UQ-SCUBA/Solid-Cell-Reader-/solid cells/BOM_Board1_PCB1_2026-08-20.csv

No. | Quantity | Comment | Designator | Footprint | Value | Manufacturer Part | Manufacturer | Supplier Part | Supplier
1 | 2 | 10uF | C3,C5 | C0603 | 10uF | CL10A106KP8NNNC | SAMSUNG(三星) | C19702 | LCSC
2 | 4 | 100nF | C4,C6,C7,C8 | C0603 | 100nF | CT41G-0603-2X1-50V-0.1uF-K(N) | TORCH(火炬) | C125205 | LCSC
3 | 2 | B3B-PH-K-S(LF)(SN) | CellOut,Head | CONN-TH_B3B-PH-K-S |  | B3B-PH-K-S(LF)(SN) | JST | C131339 | LCSC
4 | 2 | AO3401A | Cell_pwr_Q2,Wake_Q1 | SOT-23-3_L2.9-W1.3-P1.90-LS2.4-BR |  | AO3401A | YONGYUTAI(永裕泰) | C49396278 | LCSC
5 | 1 | BAV99 | D1 | SOT-23-3_L2.9-W1.4-P1.90-LS2.6-BR |  | BAV99 | IDCHIP(英锐芯) | C2848190 | LCSC
6 | 1 | B5B-PH-K-S(LF)(SN) | Program | CONN-TH_B5B-PH-K-S-LF-SN |  | B5B-PH-K-S(LF)(SN) | JST | C157993 | LCSC
7 | 1 | 20kΩ | R1 | R0603 | 20kΩ | RT0603BRD0720KL | YAGEO(国巨) | C723637 | LCSC
8 | 1 | 1kΩ | R2 | R0603 | 1kΩ | RT0603BRE071KL | YAGEO(国巨) | C513397 | LCSC
9 | 1 | 15Ω | R3 | R0603 | 15Ω | RC0603FR-0715RL | YAGEO(国巨) | C128059 | LCSC
10 | 3 | 10kΩ | R4,R5,R8 | R0603 | 10kΩ | RC0603FR-0710KL | YAGEO(国巨) | C98220 | LCSC
11 | 2 | 100kΩ | R6,R7 | R0603 | 100kΩ | RC0603FR-07100KL | YAGEO(国巨) | C14675 | LCSC
12 | 1 | B4B-PH-K-S(LF)(SN) | SolidCell | CONN-TH_B4B-PH-K-S |  | B4B-PH-K-S(LF)(SN) | JST | C131334 | LCSC
13 | 1 | STM32G051F8P6 | U1 | TSSOP-20_L6.5-W4.4-P0.65-LS6.4-BL |  | STM32G051F8P6 | ST(意法半导体) | C5270207 | LCSC
14 | 1 | MCP1703AT-3302E/CB | U2 | SOT-23-3_L2.9-W1.3-P1.90-LS2.4-BR |  | MCP1703AT-3302E/CB | MICROCHIP(美国微芯) | C144183 | LCSC
