UQ-SCUBA/Solid-Cell-Reader-/solid cells/SCH_Schematic1_2026-08-20.pdf

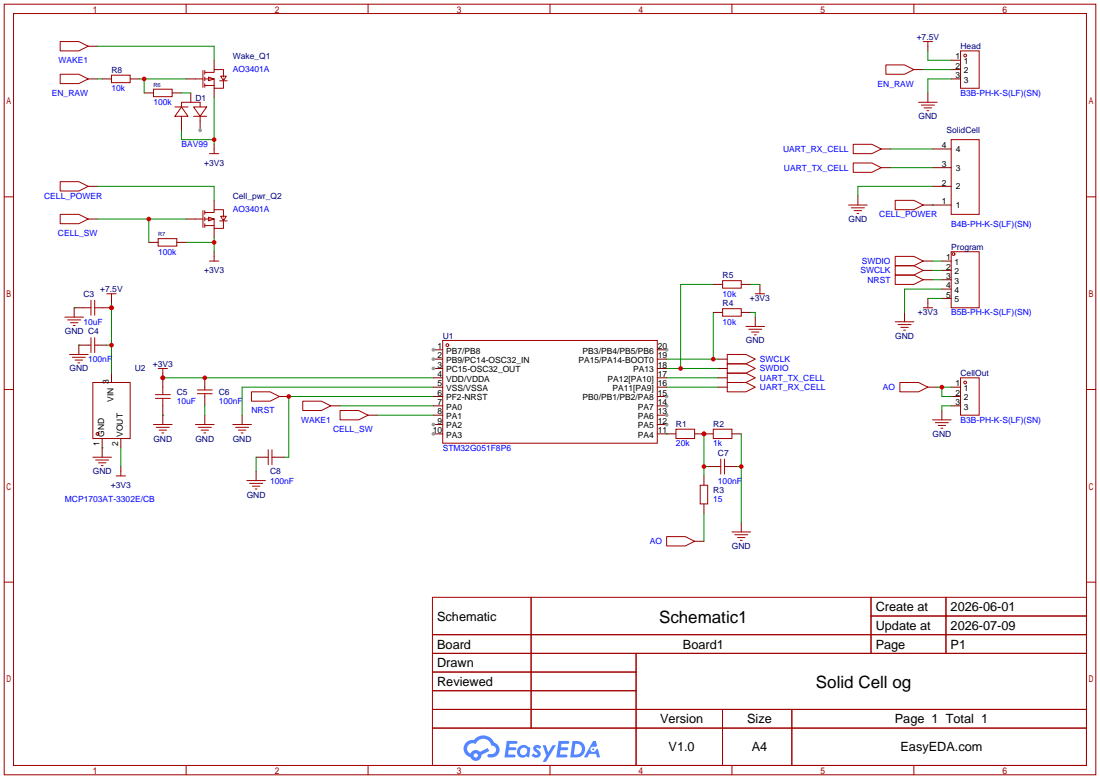
[picture p1: page 1]

Schematic | Schematic1 | Create at | 2026-06-01

Update at | 2026-07-09

Board | Board1 | Page | P1
Drawn | | Solid Cell og
Reviewed

Version | Size | Page 1 Total 1
V1.0 | A4 | EasyEDA.com
