UQ-SCUBA/Solid-Cell-Reader-/BabysFirstCell.kicad_pcb

## KiCad design BabysFirstCell.kicad_pcb (2026-03-29, last stored version)

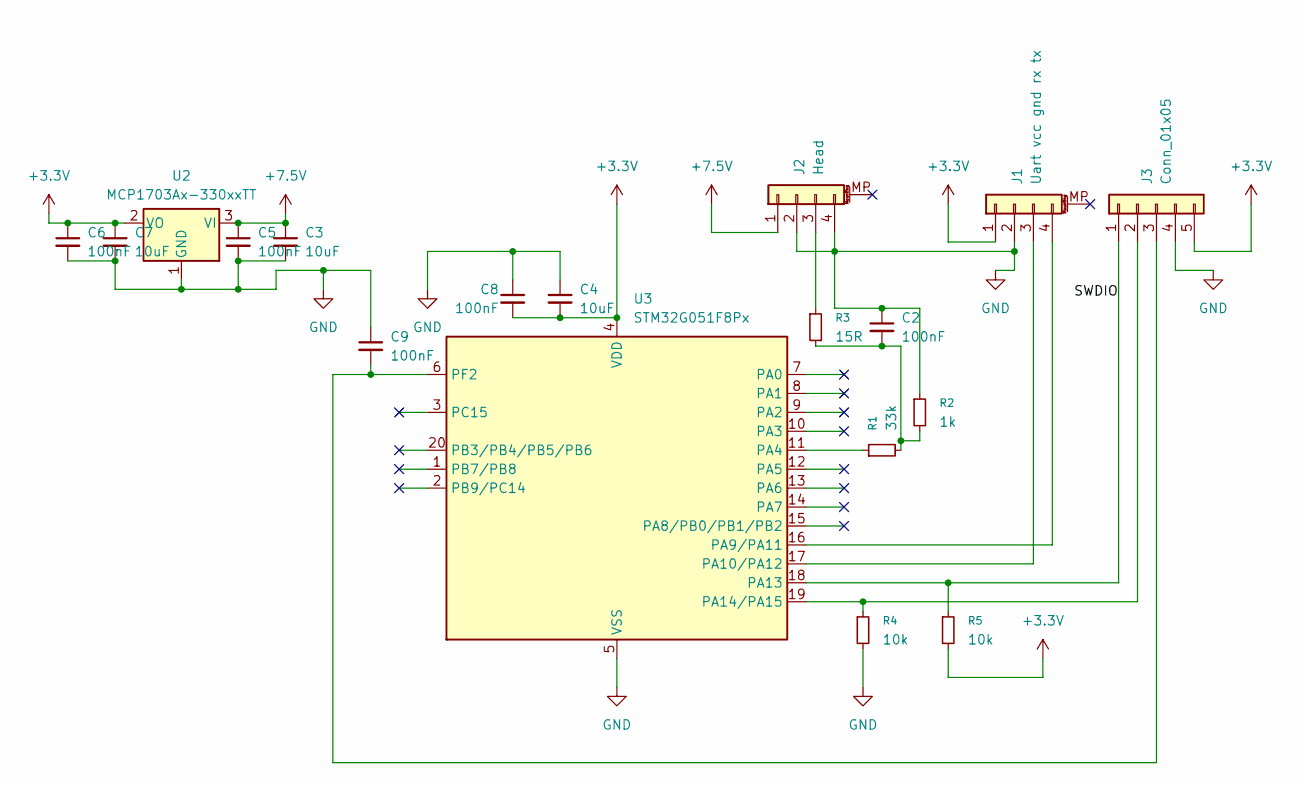
[picture p2: schematic BabysFirstCell.kicad_sch]

Parts:
C2, C5, C8, C9: 100nF; C_01005_0402Metric
C3, C4: 10uF; C_01005_0402Metric
C6: 100nF; R_0603_1608Metric
C7: 10uF; C_0201_0603Metric
J1: Uart vcc gnd rx tx; Molex_DuraClik_502352-0400_1x04-1MP_P2.00mm_Vertical
J2: Head; JST_PH_B4B-PH-K_1x04_P2.00mm_Vertical
J3: Conn_01x05; Molex_KK-396_A-41791-0005_1x05_P3.96mm_Vertical
R1: 33k; R_01005_0402Metric
R2: 1k; R_01005_0402Metric
R3: 15R; R_01005_0402Metric
R4, R5: 10k; R_01005_0402Metric
U2: MCP1703Ax-330xxTT; SOT-23
U3: STM32G051F8Px; TSSOP-20_4.4x6.5mm_P0.65mm

Connections:
+3.3V: C4.2, C6.1, C7.1, C8.2, J1.1, J3.5, R5.2, U2.2 (VO), U3.4 (VDD)
+7.5V: C3.1, C5.1, J2.1, U2.3 (VI)
/SWDIO: J3.1, R5.1, U3.18 (PA13)
GND: C2.1, C3.2, C4.1, C5.2, C6.2, C7.2, C8.1, C9.1, J1.2, J2.2, J2.4, J3.4, R2.1, R4.2, U2.1 (GND), U3.5 (VSS)
unnamed: C2.2, R1.2, R2.2, R3.2
unnamed: J1.3, U3.17 (PA10/PA12)
unnamed: J1.4, U3.16 (PA9/PA11)
unnamed: J2.3, R3.1
unnamed: J3.2, R4.1, U3.19 (PA14/PA15)
unnamed: C9.2, J3.3, U3.6 (PF2)
unnamed: R1.1, U3.11 (PA4)

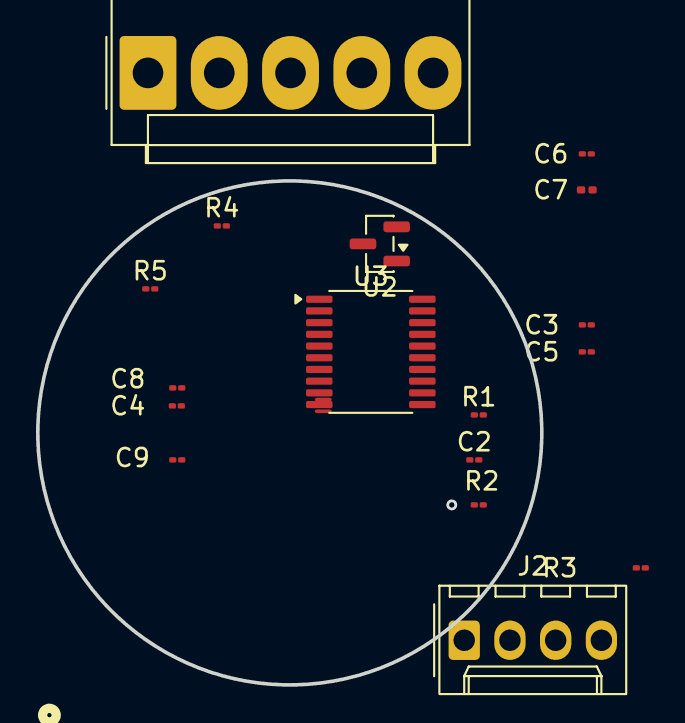
[picture p3: board BabysFirstCell.kicad_pcb from above]

Board: 4 copper layers, 28.0 x 28.0 mm, 18 parts (1 on the bottom side), 11 nets.
