UQ-SCUBA/Solid-Cell-Reader-/(commit log)

2026-03-27 Initial KiCad project upload
    [BabysFirstCell.kicad_pcb, BabysFirstCell.kicad_sch]
2026-03-29 Add EasyEDA Pro project files
    [BabysFirstCell.kicad_pcb, BabysFirstCell.kicad_sch, ProPrj_Solid Cell _2026-03-29.epro]
2026-03-29 Fixed Mistakes
    [ProPrj_Solid Cell _2026-03-29.epro]
2026-08-20 clean up
    [BabysFirstCell.kicad_pcb, BabysFirstCell.kicad_sch, ProPrj_Solid Cell _2026-03-29.epro]
2026-08-20 Add files via upload
    Current state of board and code
    [BOM_Board1_PCB1_2026-08-20.csv, PickAndPlace_PCB1_2026_08_20.csv]
2026-09-05 cellConverter: fix FDO2 USART1 pin swap, enable VCC lockout
    - Fix USART1 TX/RX pin swap: CR2.SWAP was being set via a raw register
    write after HAL_UART_Init() had already enabled the peripheral, so the
    hardware silently ignored it (SWAP can only be written while UE=0).
    This left USART1 listening/transmitting on the wrong physical pads,
    causing every #MRAW poll to the FDO2 cell to fail. Fixed by applying
    the swap through HAL's AdvancedInit mechanism, which HAL_UART_Init()
    applies before enabling the UART. Verified live on hardware via SWD:
    the comm-fail counter dropped to 0 and the DAC output settled to a
    pO2 reading matching an independent reading taken directly from the
    sa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
    [main.c]
